iu2frl/Arduino_SI5351_ARDF/README.md

# Arduino_SI5351_ARDF
Remix of the Wobbit board by IARU R1, built at 9A22YOTA camp
