iu2frl/Arduino_SI5351_ARDF/Arduino_ARDF.kicad_pcb

## KiCad design Arduino_ARDF.kicad_pcb (2022-08-22)

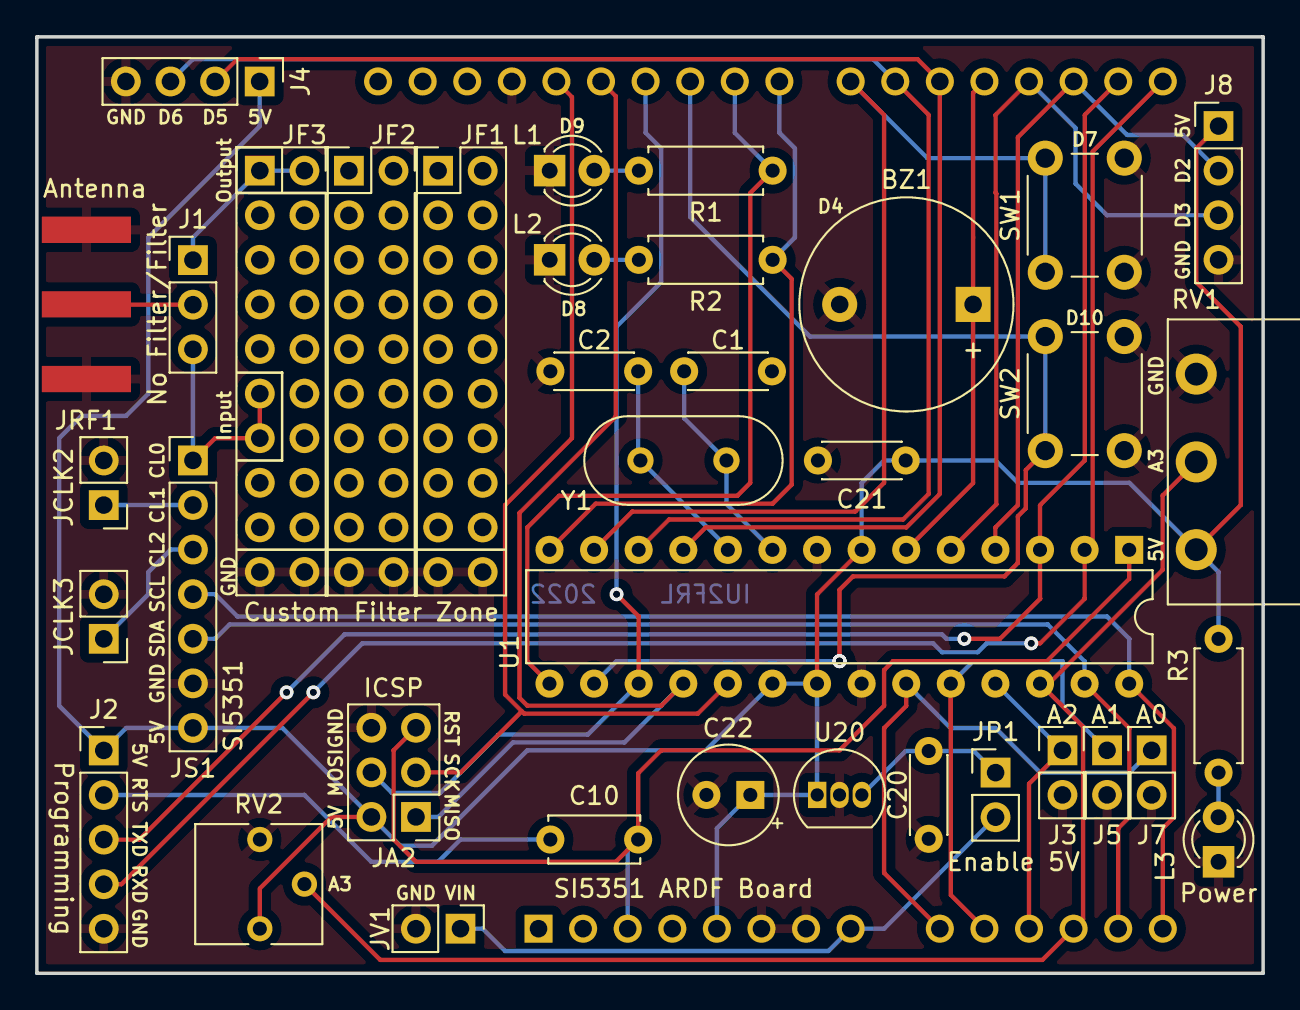
[picture p29: board Arduino_ARDF.kicad_pcb from above]

Board: 2 copper layers, 69.8 x 53.3 mm, 38 parts (1 on the bottom side), 36 nets.

Parts:
BZ1: Buzzer; Buzzer_12x9.5RM7.6
C1, C2: 18p; C_Disc_D4.3mm_W1.9mm_P5.00mm
C10: 220n; C_Disc_D5.0mm_W2.5mm_P5.00mm
C20, C21: 100n; C_Disc_D4.3mm_W1.9mm_P5.00mm
C22: 47u; CP_Radial_Tantal_D5.5mm_P2.50mm
J1: Output Mode; PinHeader_1x03_P2.54mm_Vertical
J2: Programming; PinHeader_1x05_P2.54mm_Vertical
J3: Analog 2; PinHeader_1x02_P2.54mm_Vertical
J4: AUX2; PinHeader_1x04_P2.54mm_Vertical
J5: Analog 1; PinHeader_1x02_P2.54mm_Vertical
J7: Analog 0; PinHeader_1x02_P2.54mm_Vertical
J8: AUX1; PinHeader_1x04_P2.54mm_Vertical
JA1: Arduino_UNO_R3
JA2: ICSP; PinHeader_2x03_P2.54mm_Vertical
JCLK2: Clock 2; PinHeader_1x02_P2.54mm_Vertical
JCLK3: Clock 3; PinHeader_1x02_P2.54mm_Vertical
JF1: Filter 1; PinHeader_2x10_P2.54mm_Vertical
JF2: Filter 2; PinHeader_2x10_P2.54mm_Vertical
JF3: Filter 3; PinHeader_2x10_P2.54mm_Vertical
JP1: 5V EN; PinHeader_1x02_P2.54mm_Vertical
JRF1: OUT; SMA_Amphenol_132289_EdgeMount
JS1: SI5351 Board; PinHeader_1x07_P2.54mm_Vertical
JV1: Vin; PinHeader_1x02_P2.54mm_Vertical
L1, L2, L3: LED; LED_D3.0mm
R1, R2, R3: 470; R_Axial_DIN0207_L6.3mm_D2.5mm_P7.62mm_Horizontal
RV1: Potentiometer; Potentiometer_Piher_PC-16_Single_Horizontal
RV2: Potentiometer; Potentiometer_Vishay_T73YP_Vertical
SW1: Button 1; SW_PUSH_6mm
SW2: Button 2; SW_PUSH_6mm
U1: ATmega328-P; DIP-28_W7.62mm
U20: L78L05_TO92; TO-92_Inline
Y1: 16M; Crystal_HC18-U_Vertical

Connections:
+5V: C21.1, C22.1, J2.1, J4.1, J8.1, JA1.5 (+5V), JA2.2, JS1.7, R3.1, RV1.1, RV2.1, U1.7 (VCC), U1.20 (AVCC), U1.21 (AREF), U20.1 (VO)
A0: J7.1, JA1.9 (A0), U1.23 (PC0)
A1: J5.1, JA1.10 (A1), U1.24 (PC1)
A2: J3.1, JA1.11 (A2), U1.25 (PC2)
A3: JA1.12 (A3), RV1.2, RV2.2, U1.26 (PC3)
BUZ: BZ1.1 (-), JA1.19 (D4), U1.6 (PD4)
CLK0: J1.3, JF3.11, JF3.13, JS1.1
CLK1: JCLK2.1, JS1.2
CLK2: JCLK3.1, JS1.3
D2: J8.2, JA1.17 (D2), U1.4 (PD2)
D3: J8.3, JA1.18 (D3), U1.5 (PD3)
D5: J4.2, JA1.20 (D5), U1.11 (PD5)
D6: J4.3, JA1.21 (D6), U1.12 (PD6)
D7: JA1.22 (D7), SW1.1, U1.13 (PD7)
D10: JA1.25 (D10), SW2.1, U1.16 (PB2)
Filter: J1.1, JF3.1, JF3.2
GND: BZ1.2 (+), C1.1, C2.2, C20.2, C21.2, C22.2, J2.5, J3.2, J4.4, J5.2, J7.2, J8.4, JA1.6 (GND), JA1.7 (GND), JA1.29 (GND), JA2.6, JCLK2.2, JCLK3.2, JF1.19, JF1.20, JF2.19, JF2.20, JF3.19, JF3.20, JRF1.2 (Ext), JS1.6, JV1.2, L1.1 (K), L2.1 (K), L3.1 (K), RV1.3, RV2.3, SW1.2, SW2.2, U1.8 (GND), U1.22 (GND), U20.2 (GND)
LED1: JA1.24 (D9), R1.1, U1.15 (PB1)
LED2: JA1.23 (D8), R2.1, U1.14 (PB0)
MISO: JA1.27 (D12), JA2.1, U1.18 (PB4)
MOSI: JA1.26 (D11), JA2.4, U1.17 (PB3)
unnamed: C1.2, U1.9 (XTAL1/PB6), Y1.2
unnamed: C2.1, U1.10 (XTAL2/PB7), Y1.1
unnamed: C10.1, J2.2
unnamed: C20.1, JP1.1, U20.3 (VI)
unnamed: J1.2, JRF1.1 (In)
unnamed: L1.2 (A), R1.2
unnamed: L2.2 (A), R2.2
unnamed: L3.2 (A), R3.2
RST: C10.2, JA1.3 (~RESET), JA2.5, U1.1 (~RESET/PC6)
RXD: J2.4, JA1.15 (D0/RX), U1.2 (PD0)
SCK: JA1.28 (D13), JA2.3, U1.19 (PB5)
SCL: JA1.14 (SCL/A5), JS1.4, U1.28 (PC5)
SDA: JA1.13 (SDA/A4), JS1.5, U1.27 (PC4)
TXD: J2.3, JA1.16 (D1/TX), U1.3 (PD1)
VIN: JA1.8 (VIN), JP1.2, JV1.1
