iu2frl/Arduino_SI5351_ARDF/Versione_9A22YOTA/Schematic/Schematic.kicad_pcb

## KiCad design Versione_9A22YOTA/Schematic/Schematic.kicad_pcb (2022-08-20)

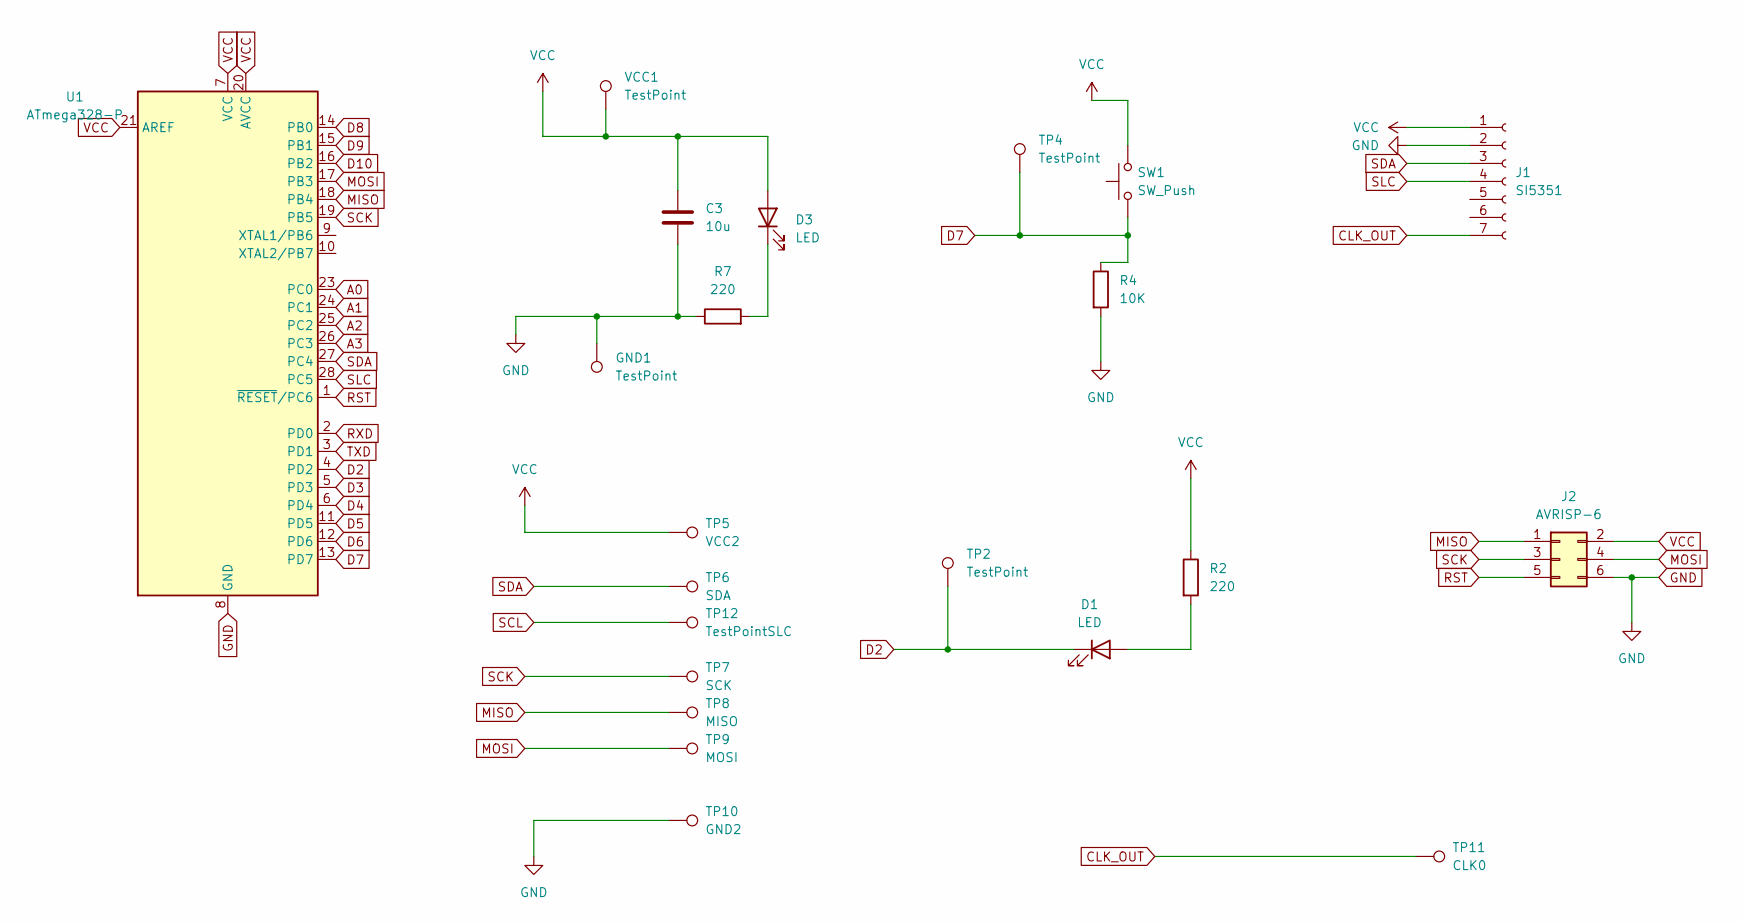
[picture p30: schematic Schematic.kicad_sch]

Parts:
C3: 10u; CP_Radial_D5.0mm_P2.00mm
D1, D3: LED; LED_D5.0mm
GND1: TestPoint; Pin_D1.0mm_L10.0mm
J1: SI5351; PinHeader_1x07_P2.54mm_Vertical
J2: AVRISP-6; PinHeader_2x03_P2.54mm_Vertical
R2, R7: 220; R_Axial_DIN0309_L9.0mm_D3.2mm_P12.70mm_Horizontal
R4: 10K; R_Axial_DIN0309_L9.0mm_D3.2mm_P12.70mm_Horizontal
SW1: SW_Push; SW_PUSH_6mm
TP2, TP4: TestPoint; Pin_D1.0mm_L10.0mm
TP5: VCC2; Pin_D1.0mm_L10.0mm
TP6: SDA; Pin_D1.0mm_L10.0mm
TP7: SCK; Pin_D1.0mm_L10.0mm
TP8: MISO; Pin_D1.0mm_L10.0mm
TP9: MOSI; Pin_D1.0mm_L10.0mm
TP10: GND2; Pin_D1.0mm_L10.0mm
TP11: CLK0; Pin_D1.0mm_L10.0mm
TP12: TestPointSLC; Pin_D1.0mm_L10.0mm
U1: ATmega328-P; DIP-28_W7.62mm
VCC1: TestPoint; Pin_D1.0mm_L10.0mm

Connections:
A0: U1.23 (PC0)
A1: U1.24 (PC1)
A2: U1.25 (PC2)
A3: U1.26 (PC3)
CLK_OUT: J1.7, TP11.1
D2: D1.1 (K), TP2.1, U1.4 (PD2)
D3: U1.5 (PD3)
D4: U1.6 (PD4)
D5: U1.11 (PD5)
D6: U1.12 (PD6)
D7: R4.1, SW1.1, TP4.1, U1.13 (PD7)
D8: U1.14 (PB0)
D9: U1.15 (PB1)
D10: U1.16 (PB2)
GND: C3.2, GND1.1, J1.2, J2.6, R4.2, R7.1, TP10.1, U1.8 (GND), U1.22 (GND)
MISO: J2.1, TP8.1, U1.18 (PB4)
MOSI: J2.4, TP9.1, U1.17 (PB3)
unnamed: D1.2 (A), R2.2
unnamed: D3.1 (K), R7.2
RST: J2.5, U1.1 (~RESET/PC6)
RXD: U1.2 (PD0)
SCK: J2.3, TP7.1, U1.19 (PB5)
SCL: TP12.1
SDA: J1.3, TP6.1, U1.27 (PC4)
SLC: J1.4, U1.28 (PC5)
TXD: U1.3 (PD1)
VCC: C3.1, D3.2 (A), J1.1, J2.2, R2.1, SW1.2, TP5.1, U1.7 (VCC), U1.20 (AVCC), U1.21 (AREF), VCC1.1

Board: 2 copper layers, 22 parts (0 on the bottom side), 13 nets, no tracks yet.
