iu2frl/Arduino_SI5351_ARDF/(commit log)

2022-08-20 Iniziato versione 9A22YOTA
    [Schematic.kicad_pcb, Schematic.kicad_sch]
2022-08-21 Iniziato PCB
    [Arduino_ARDF.kicad_pcb, Arduino_ARDF.kicad_sch]
2022-08-21 Ricominciato PCB
    [Arduino_ARDF.kicad_pcb, Arduino_ARDF.kicad_sch]
2022-08-22 Added workflow
    [Arduino_ARDF.kicad_pcb, Arduino_ARDF.kicad_sch]
2022-08-22 Finished PCB
    [Arduino_ARDF.kicad_pcb, Arduino_ARDF.kicad_sch]
